interoberlin/Baumhaus-Tree-Adapter/PCB 3D.jpg

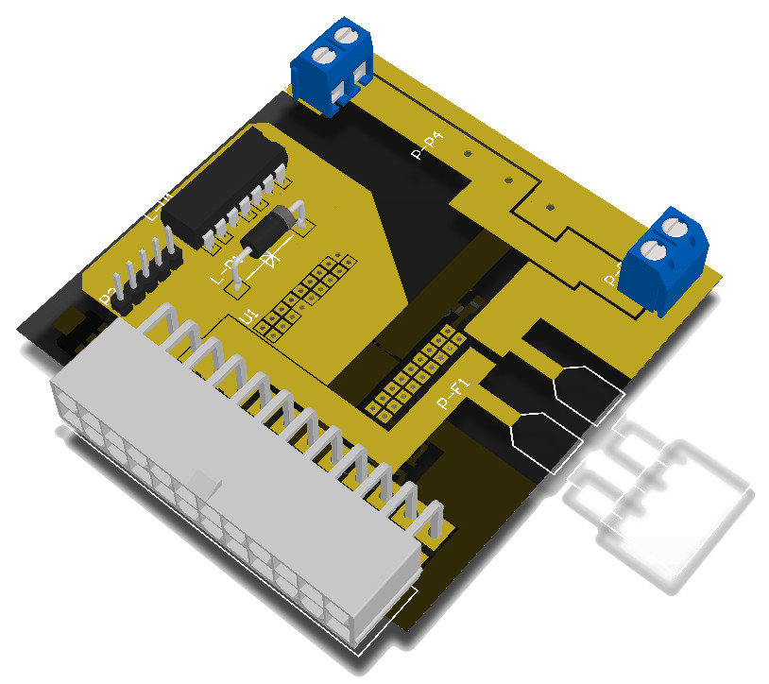
PCB 3D.jpg
