interoberlin/Baumhaus-Tree-Adapter/Level Shifter.jpg

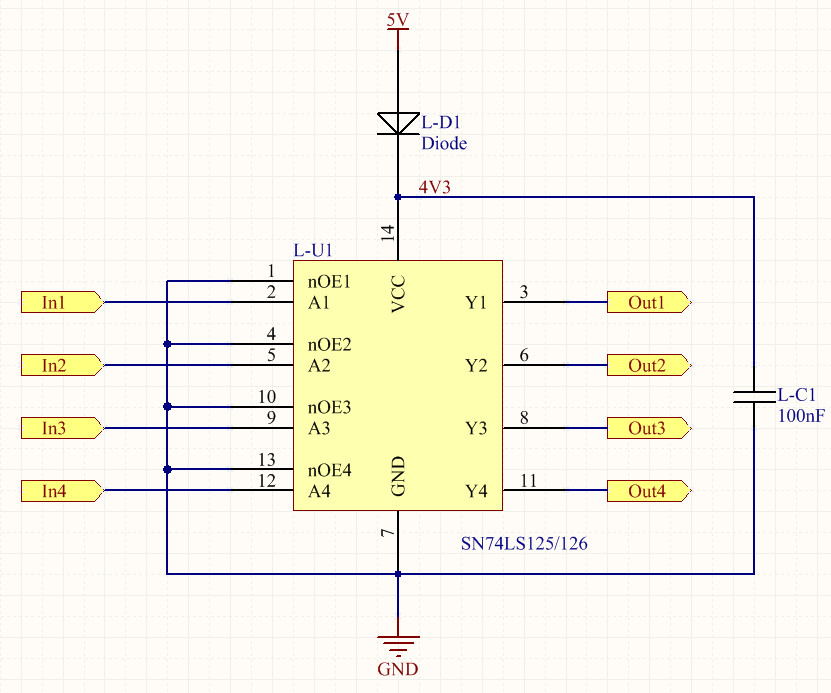
Level Shifter.jpg
