interoberlin/Baumhaus-Tree-Adapter/PCB - Bottom Layer.jpg

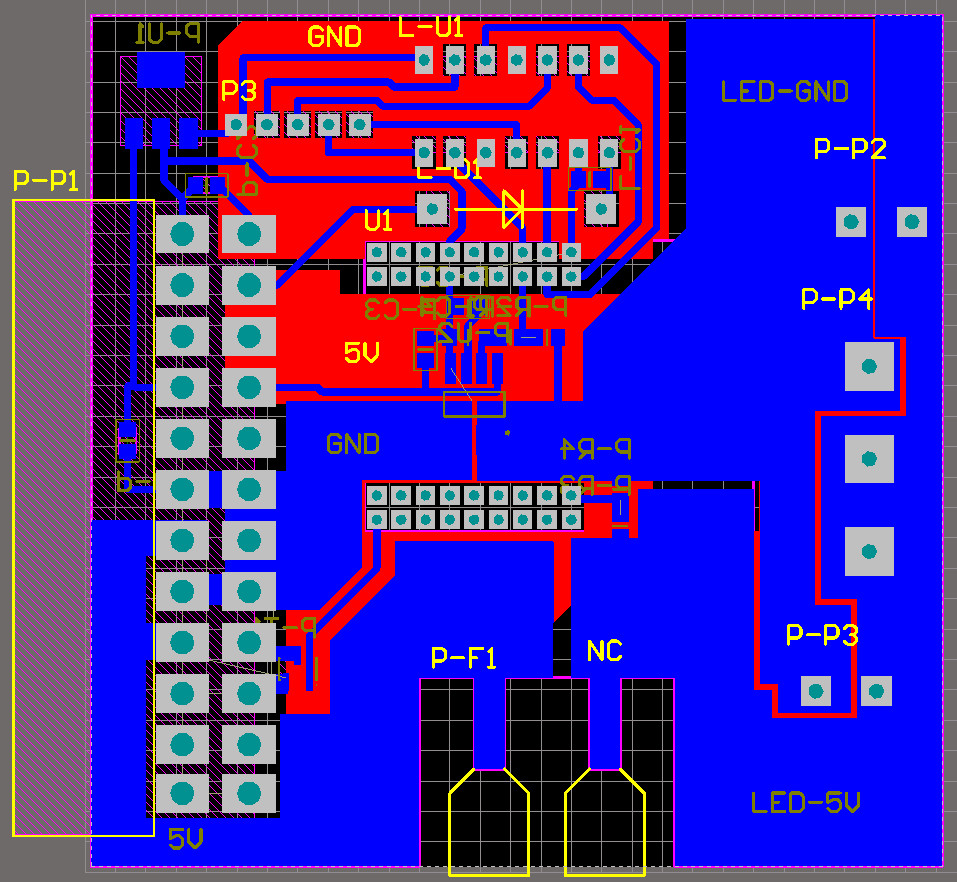
PCB - Bottom Layer.jpg
