interoberlin/Baumhaus-Tree-Adapter/PCB - Top Layer.jpg

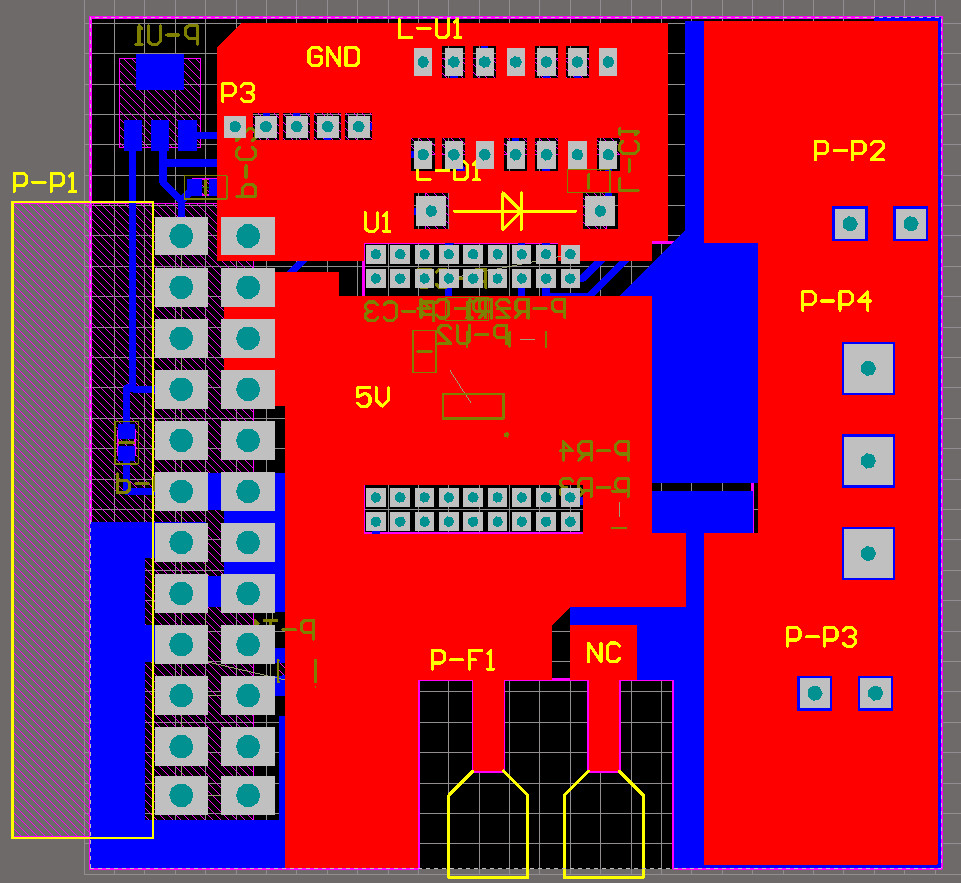
PCB - Top Layer.jpg
