interoberlin/Baumhaus-Tree-Adapter/Power.jpg

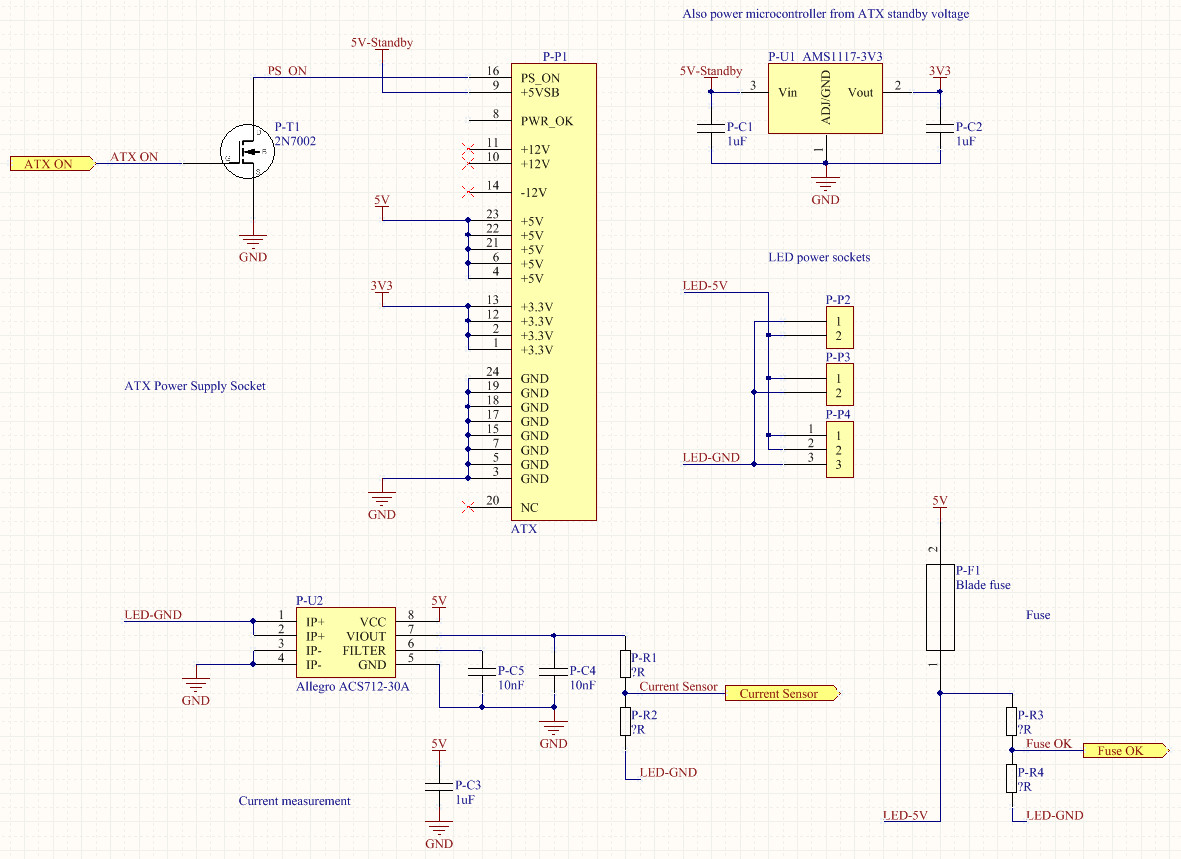
Power.jpg
