interoberlin/Baumhaus-Tree-Adapter/SWD.jpg

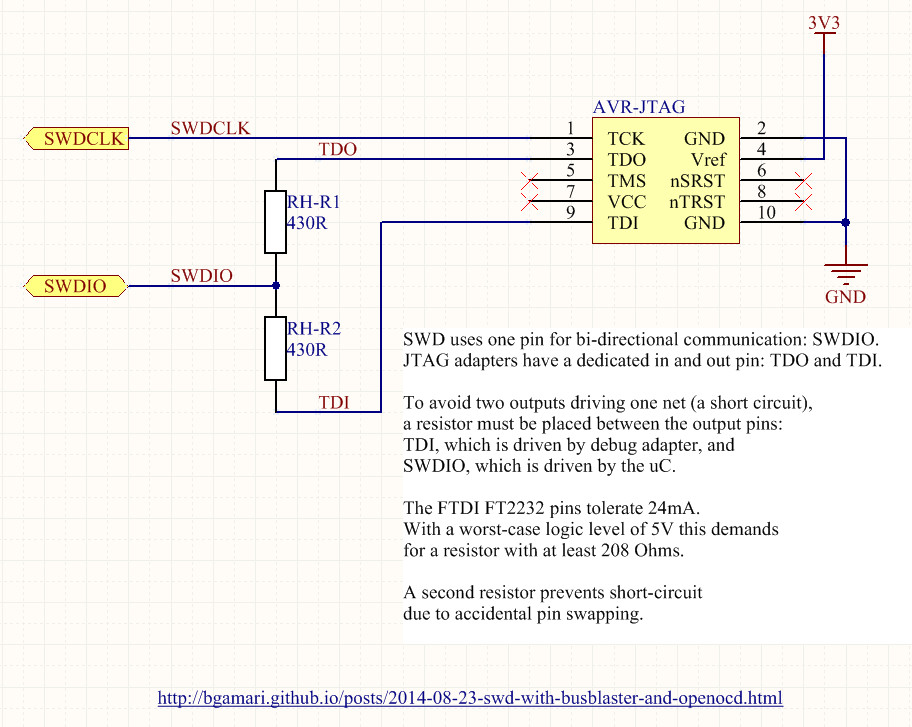
SWD.jpg
