interoberlin/Baumhaus-Tree-Adapter/Top.jpg

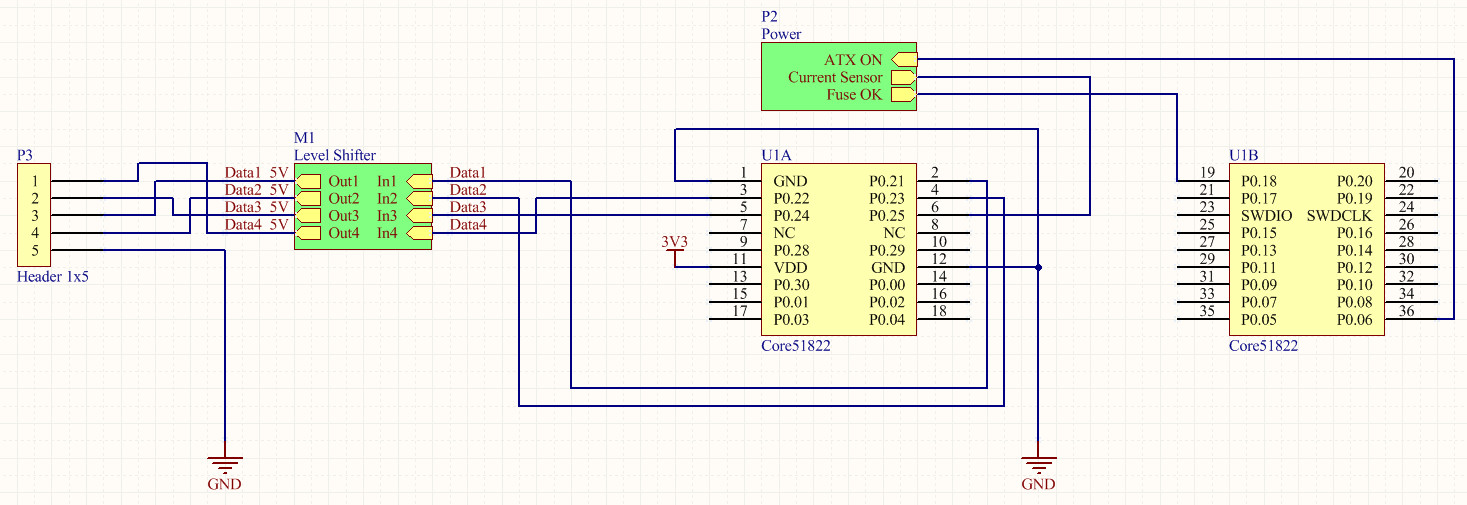
Top.jpg
