interoberlin/Baumhaus-Tree-Adapter/(list of files, drawings)

Other design files:
Adapter-LEDs.PrjPCB
Adapter.PcbDoc
Adapter.PrjPCB
LED+Transistor.SchDoc
Level Shifter.SchDoc
Multi-Nutzen x4.PcbDoc
Power.SchDoc
SWD.SchDoc
Top.SchDoc
