interoberlin/Baumhaus-Tree-Adapter/(threads)

Thread 1 (2017-05-06):

Voltage level shifter not operational with diode

matthiasbock, 2017-05-06:
There is an issue in commit 73792292f003ea181c48f09c0ef719e24166e6e9:
Diode L-D1 drops the supply voltage from 5V to 4.3V.
The TI SN74LS125AN requires at least 4.5V though,
otherwise it outputs only 3.3V.

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

Thread 2 (2017-05-06):

PCB not working with 74xx126

matthiasbock, 2017-05-06:
The TI SN74LS126 has inverted output enable pins,
pulling those to GND disables the voltage level shifter.
