interoberlin/Baumhaus-Tree-Adapter/pinout.h

/**
 * Tree adapter functions to nRF51822 pin assignments
 */

#ifndef PINOUT_H
#define PINOUT_H

#define PIN_LED_DATA1       21
#define PIN_LED_DATA2       23
#define PIN_LED_DATA3       24
#define PIN_LED_DATA4       22

#define PIN_ATX_ON          6

#define PIN_FUSE_OK         18

#define PIN_CURRENT_SENSOR  25

#endif // PINOUT_H
