interoberlin/Baumhaus-Tree-Adapter/(commit log)

2016-09-26 begin with empty project
    [Adapter.PcbDoc, Adapter.PrjPCB, Top.SchDoc]
2016-09-26 included libraries in project
    [Adapter-LEDs.PrjPCB]
2016-09-26 first draft
    [Adapter-LEDs.PrjPCB, Adapter.PcbDoc, Level Shifter.SchDoc, Top.SchDoc]
2016-11-04 Revision 1.0 designed
    [Adapter-LEDs.PrjPCB, Adapter.PcbDoc, LED.SchDoc, Level Shifter.SchDoc, SWD.SchDoc, Top.SchDoc]
2016-11-04 generated fabrication files
    [Adapter.GBL, Adapter.GKO, Adapter.GM1]
2016-11-14 bigger holes for power cables (diameter 2mm) LDO for standby power supply
    [Adapter-LEDs.PrjPCB, Adapter.PcbDoc, Top.SchDoc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]
2016-11-14 fixed fatal design error: Core51822 must be mirrored
    [Adapter-LEDs.PrjPCB, Adapter.PcbDoc, Nutzen-1x4.PcbDoc, Top.SchDoc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]
2016-11-17 began addressing several drawbacks in the design...
    [Adapter-LEDs.PrjPCB, LED+Transistor.SchDoc, LED.SchDoc, Power.SchDoc, Top.SchDoc]
2016-12-09 Abschnitt 'Analyse' hinzugefuegt Abschnitte 'Ausgangssituation' und 'Anforderungen' weiterentwickelt
2016-12-30 Kapitel 'Auswirkungen' und Abkuerzungsverzeichnis hinzugefuegt
2017-03-13 designed Power schematic with ATX socket, power-on transistor, fuse and standby voltage LDO
    [Power.SchDoc]
2017-03-13 designed adapter revision 2
    [Adapter-LEDs.PrjPCB, Adapter.PcbDoc, Level Shifter.SchDoc, Power.SchDoc, Top.SchDoc]
2017-03-13 fixed board outline
    [Adapter.PcbDoc]
2017-03-13 exported fabrication files
    [Adapter-LEDs.PrjPCB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]
2017-03-18 added CircuitCAM and BoardMaster files
2017-04-10 designed board revision 3 * moved Core51822 * increased copper surface * fixed pin assignment at power headers
    [Adapter-LEDs.PrjPCB, Adapter.PcbDoc, Level Shifter.SchDoc, Power.SchDoc, Top.SchDoc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]
2017-04-10 created 4x Multi-Nutzen
    [Multi-Nutzen x4.PcbDoc, Nutzen-1x4.PcbDoc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]
2017-04-22 PCB fabricated
2017-04-22 added power net labels to overlays
    [Adapter.PcbDoc]
2017-05-07 updated pinout.h: removed ATX_OK pin
